AgileCPS/neuralwear/schematics/NeuralWear_Controller_v1.0.pdf

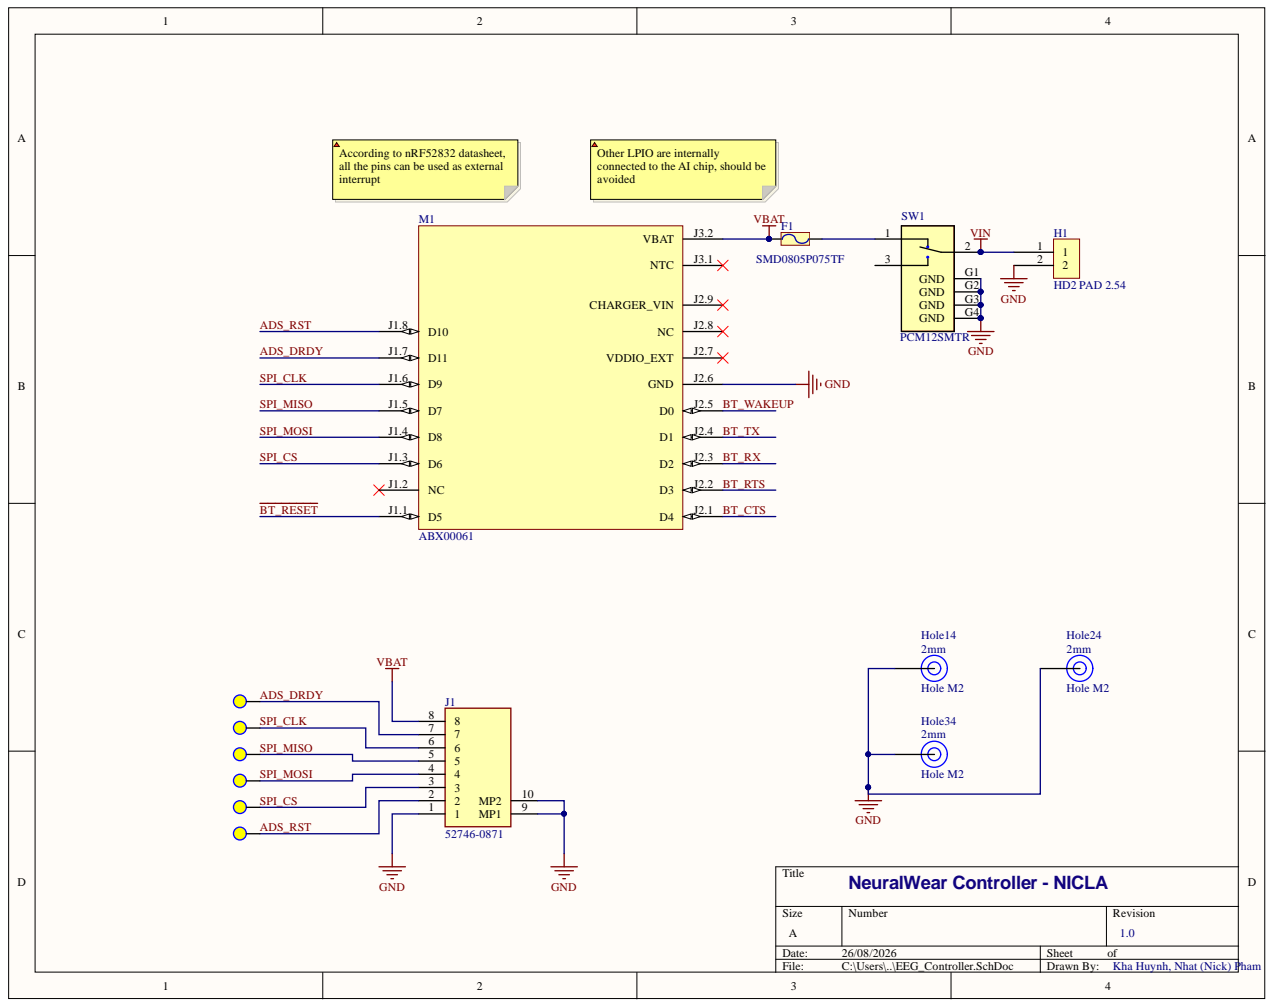
[picture p1: page 1]

According to nRF52832 datasheet,
all the pins can be used as external
interrupt

Other LPIO are internally
connected to the AI chip, should be
avoided

Size A | Number | Revision 1.0

Date: 26/08/2026 | Sheet of
File: C:\Users\..\EEG_Controller.SchDoc | Drawn By:

Kha Huynh, Nhat (Nick) Pham

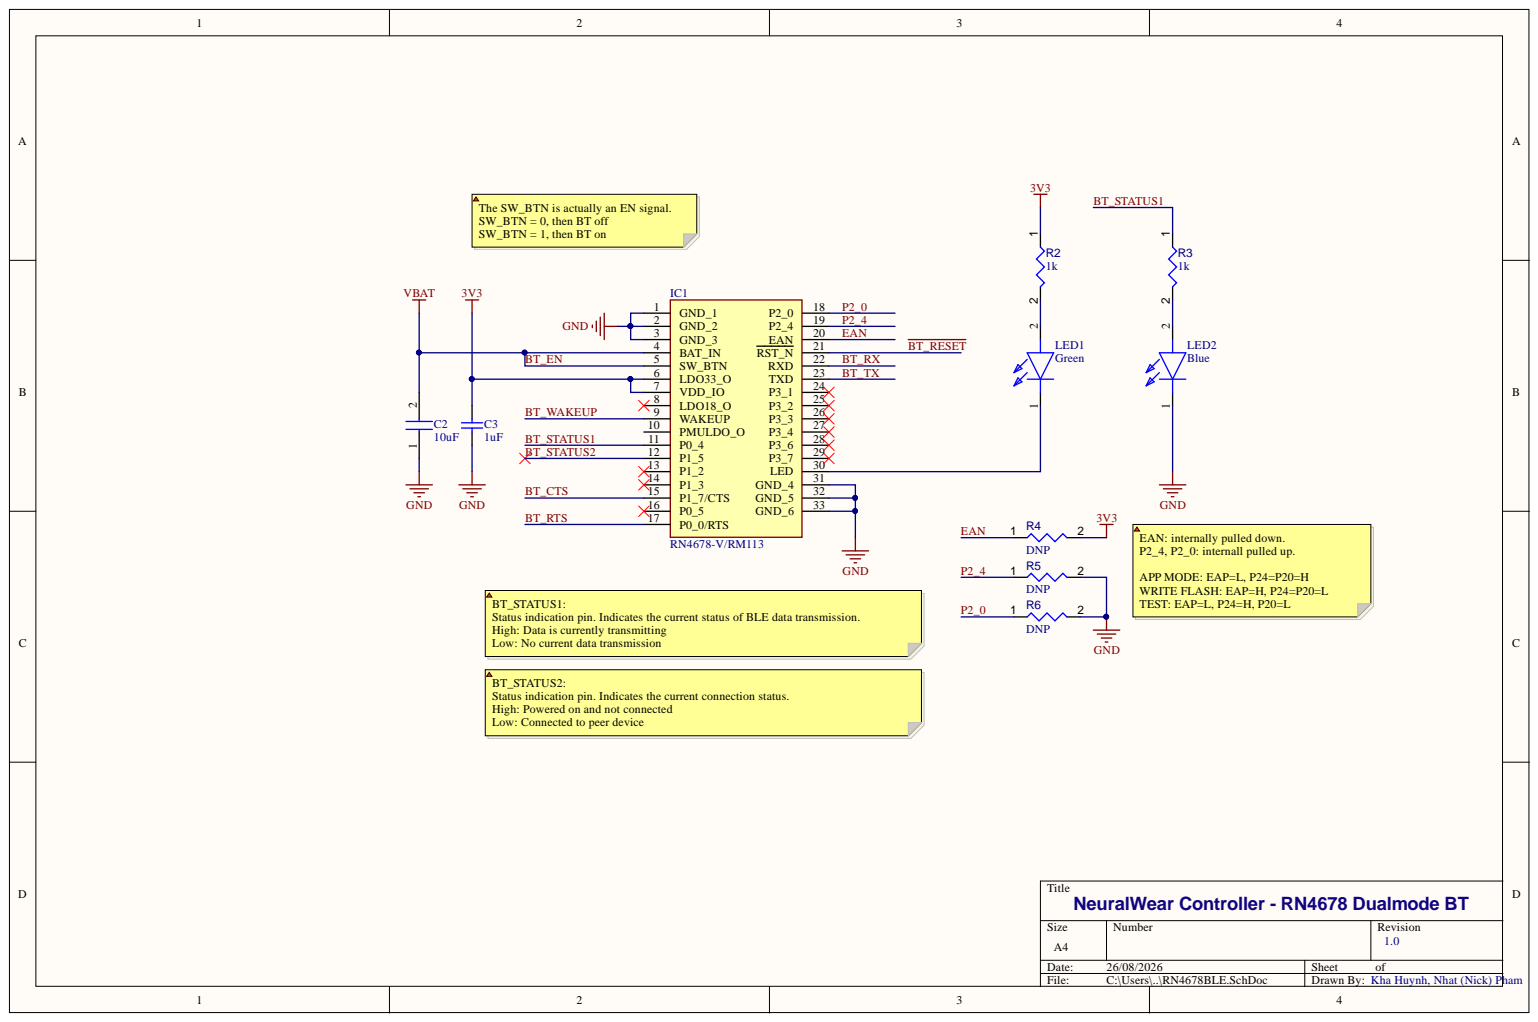
[picture p2: page 2]

3 2
3 3

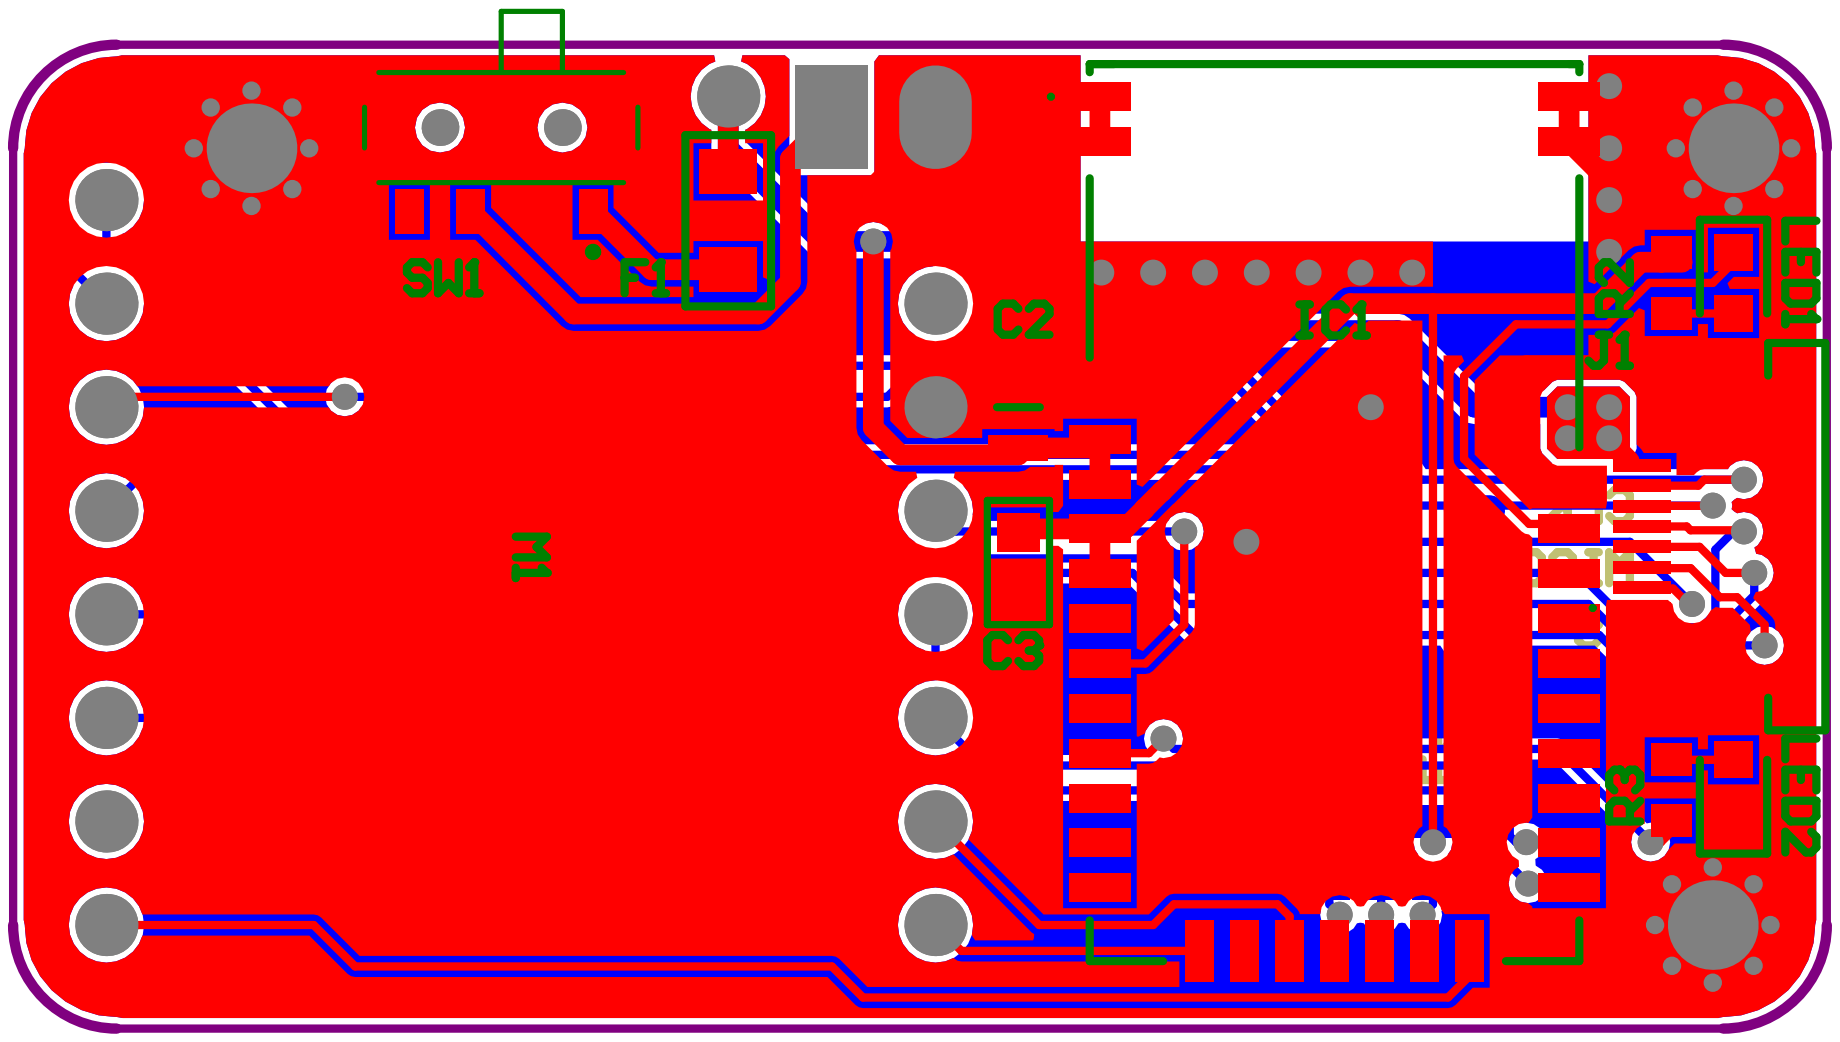
[picture p3: page 3]
