AgileCPS/neuralwear/schematics/NeuralWear_EEG_Shield_v1.0.pdf

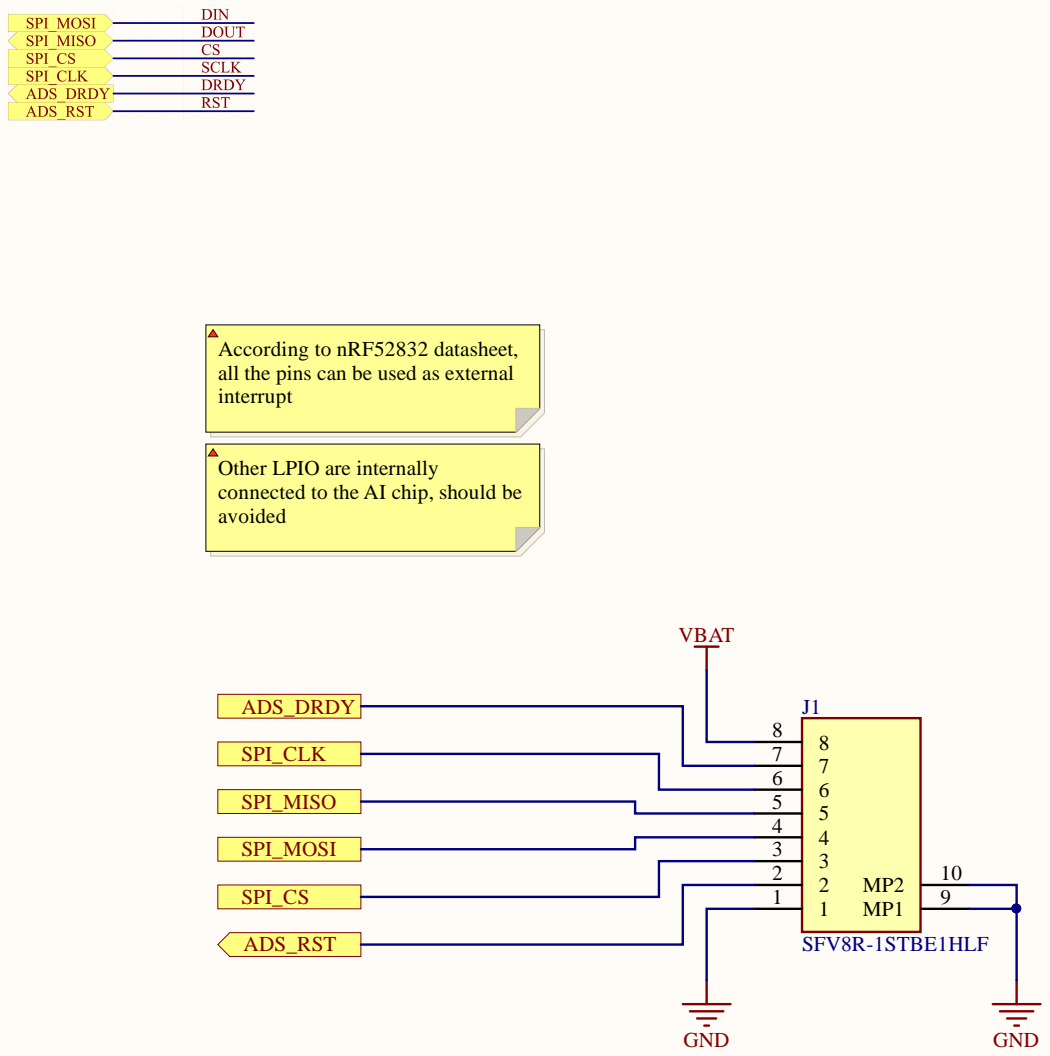
[picture p4: page 1]

Acco
all the pins can be used as exter
inter

Other LPIO are inter

nected to the AI chip, sh

SPI _MISO | 5

SPI _MOSI | 3

SPI _ C S | | 1

Size A | Nu m ber | Revisio n 1.0

Date: 6/0 8/2 6 | Sheet o f
File: C:\Users\..\ExMCUC o n necto r.SchDo c | Drawn B y : Kha Hu y n h, Nhat (Nick

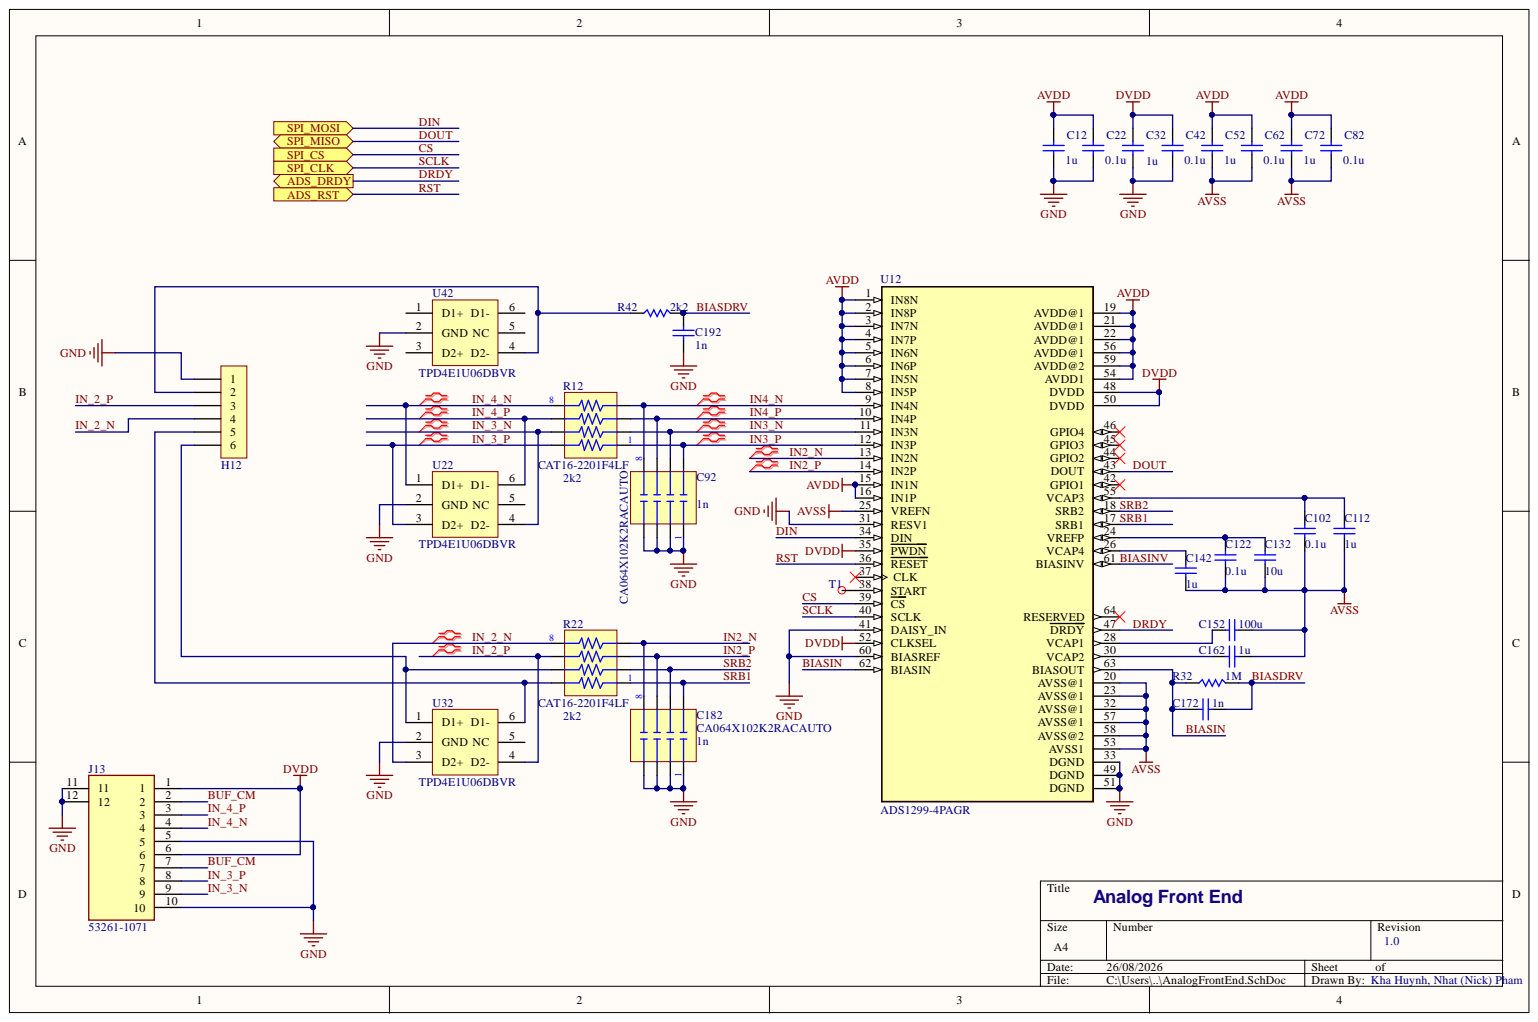
[picture p5: page 2]

SRB2

DIN | | SRB1

BIASIN

Kha Huynh, Nhat (Nick) Pham

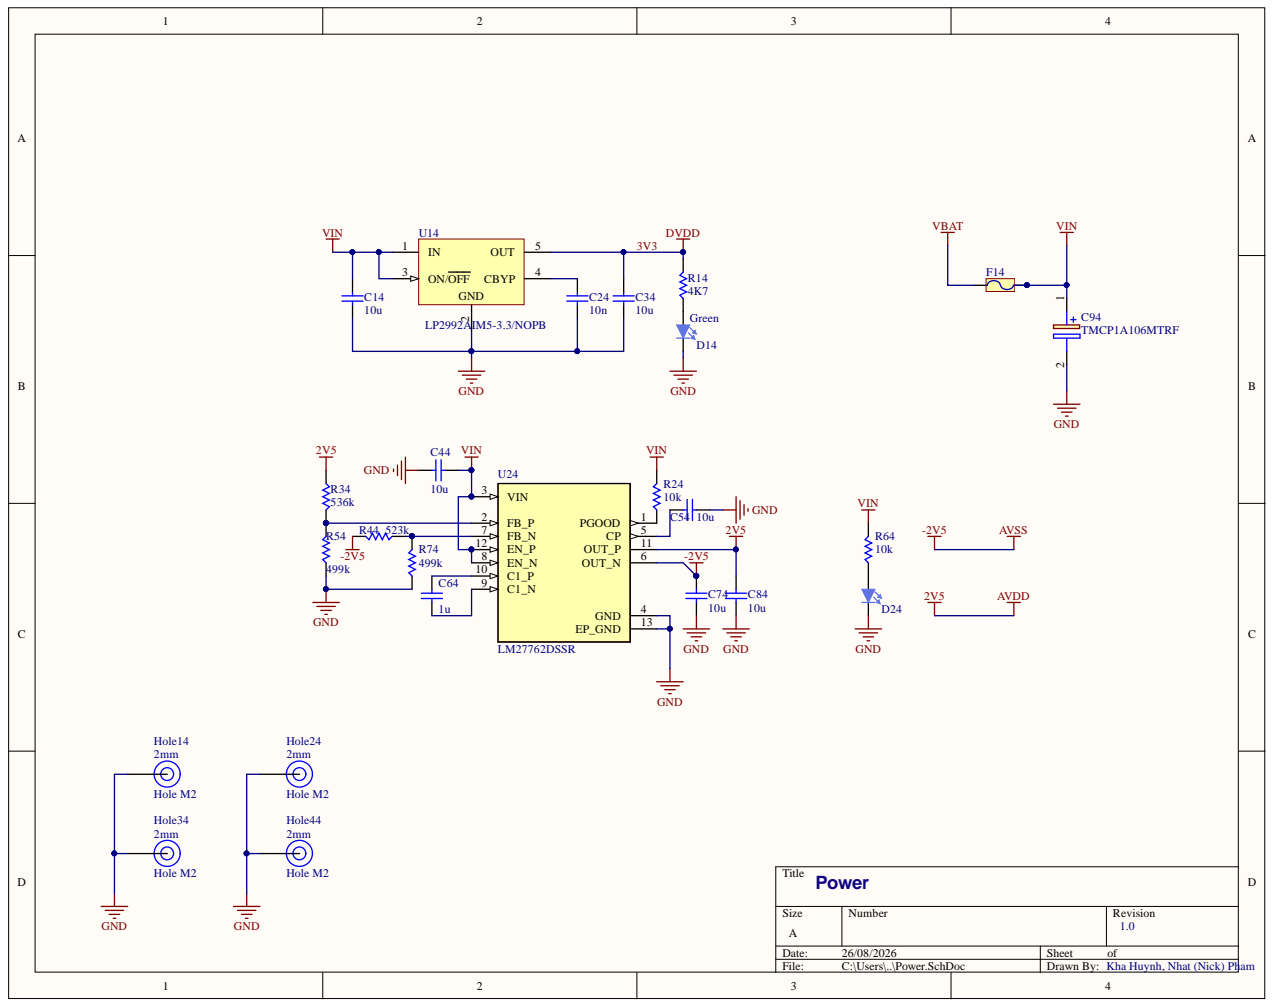
[picture p6: page 3]

Size A | Number | Revision 1.0

Date: 26/08/2026 | Sheet of
File: C:\Users\..\Power.SchDoc | Drawn By:

Kha Huynh, Nhat (Nick) Pham

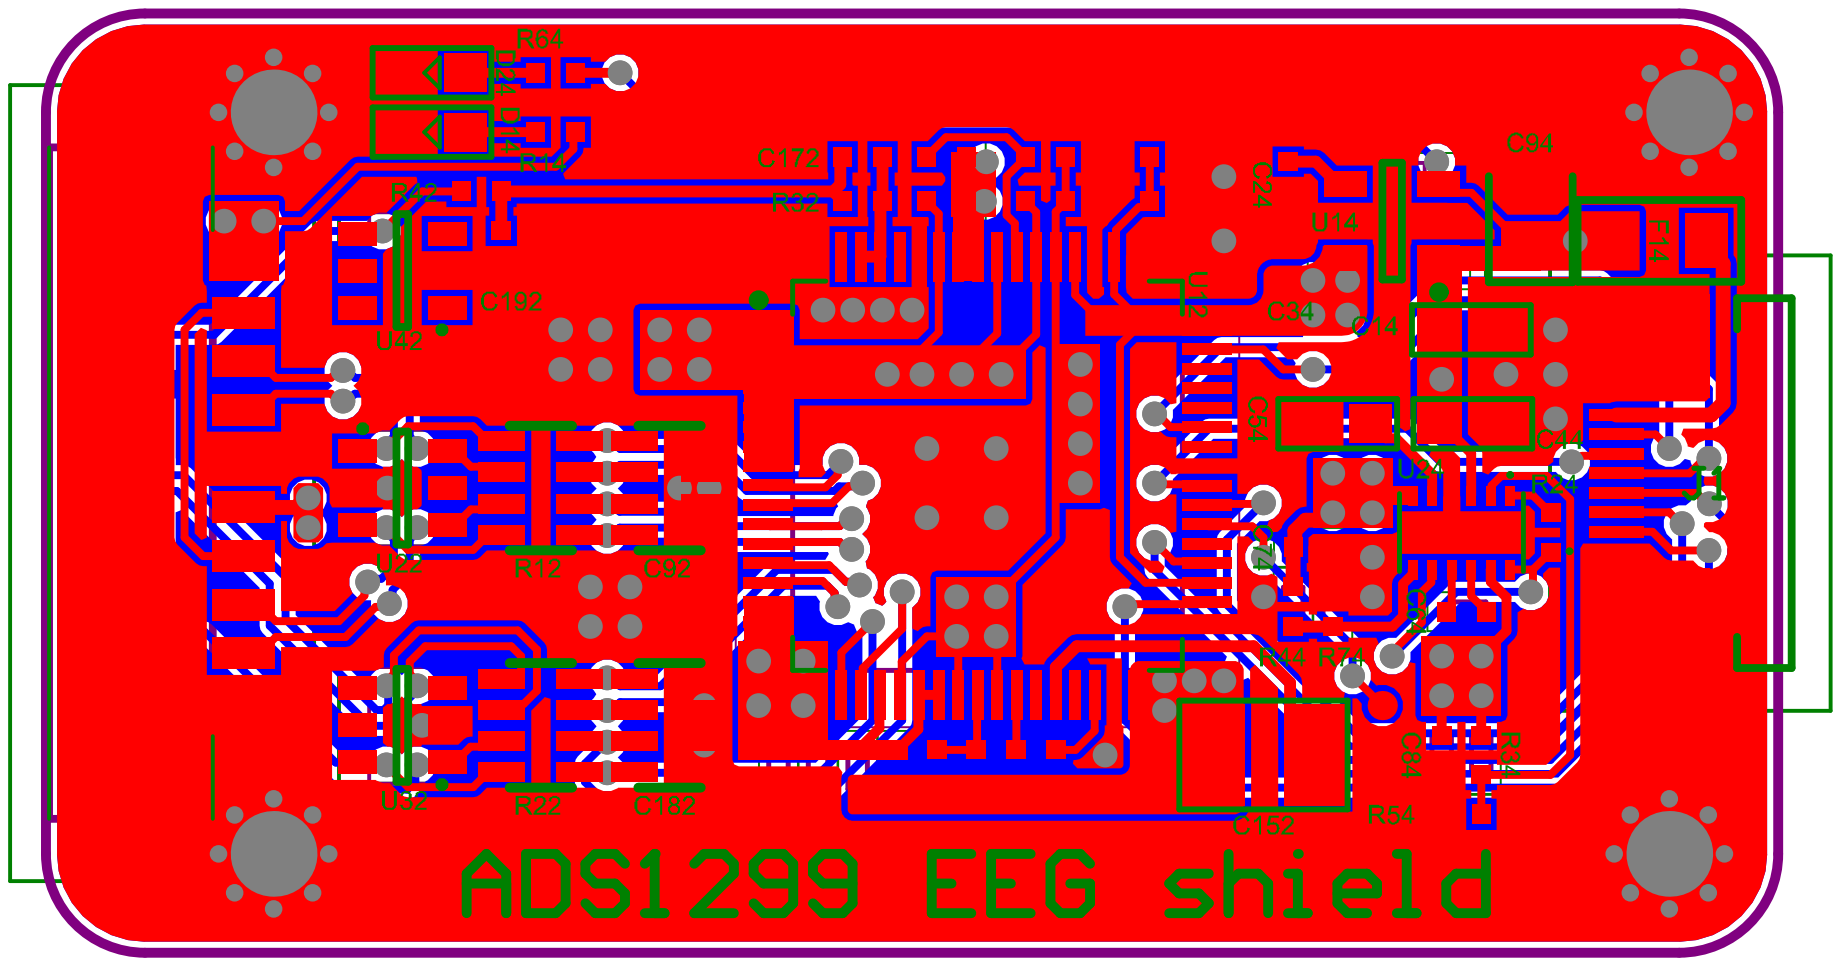
[picture p7: page 4]
