AgileCPS/neuralwear/(commit log)

2026-08-26 [Critical] Enable UART hw flow control on the NICLA Voice
2026-08-26 Added hardware schematics for neuralwear controller and EEG shield.
2026-08-27 updated OpenVibe driver
2026-11-05 increase the charging current to 300mA
